benvrakas/1000W-LED-Controller/docs/Pics/IMG_6099.png

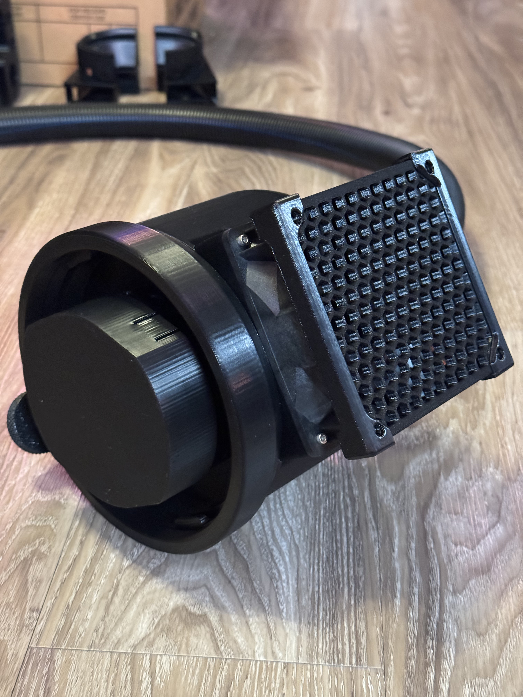
docs/Pics/IMG_6099.png
