benvrakas/1000W-LED-Controller/docs/Pin Uses.docx

Here are the connections for the Feather

Wrong Outdated Circuit Python Name! (Do Not Use) | Board Pin Number | Circuit Python Name | GPIO Name | Connected To
SPARE | 16 | D4 | PA14 | Aux lens cooling fan PWM
D1 | 19 | D5 | PA16 | Rad Fan PWM
D0 | 20 | D6 | PA18 | Pump PWM
D3 | 21 | D9 | PA19 | PSU fan PWM
D2 | 22 | D10 | PA20 | Rad Fan Tach
D5 | 23 | D11 | PA21 | Pump Tach
D4 | 24 | D12 | PA22 | PSU Fan Tach
D6 | 25 | D13 | PA23 | Aux lens cooling fan Tach
same | 14 | RX | PB17 | Encoder A
same | 15 | TX | PB16 | Encoder B
same | 17 | SDA | PA12 | Feather Wing OLED SDA
same | 18 | SCL | PA13 | Feather Wing OLED SLC
same | 5 | A0 | PA02 | 10K+10K voltage divider (thermistor connected to ground) for LED Temp
same | 6 | A1 | PA05 | 10K+10K voltage divider (thermistor connected to ground) for Water Temp
same | 7 | A2 | PA08 | Driving the switch LED
same | 8 | A3 | PA09 | Switch signal
same | 9 | A4 | PA04 | UHP 1500 Remote On OFF
same | 10 | A5 | PA06 | Unused

On the feather:

CanH is orange

CanL is red

Gnd is white
