benvrakas/1000W-LED-Controller/docs/Hardware/1000w LED.png

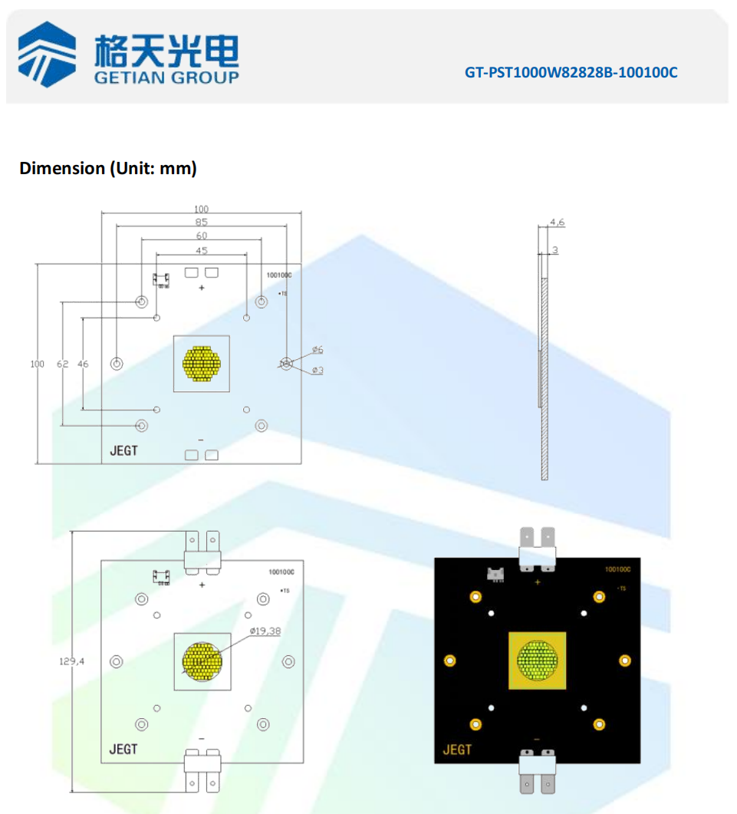
docs/Hardware/1000w LED.png
