benvrakas/1000W-LED-Controller/docs/Pics/IMG_5307.png

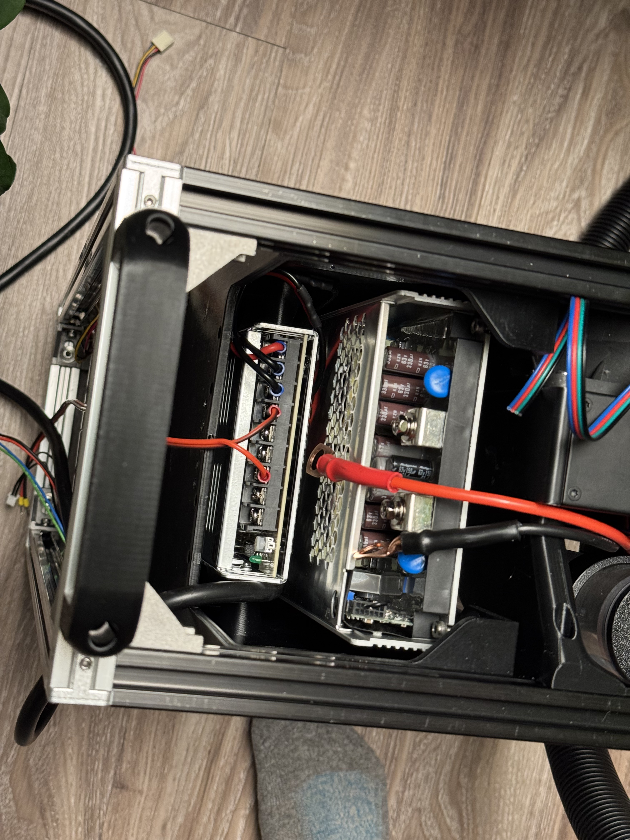
docs/Pics/IMG_5307.png
