benvrakas/1000W-LED-Controller/docs/Pics/Power Pack2.png

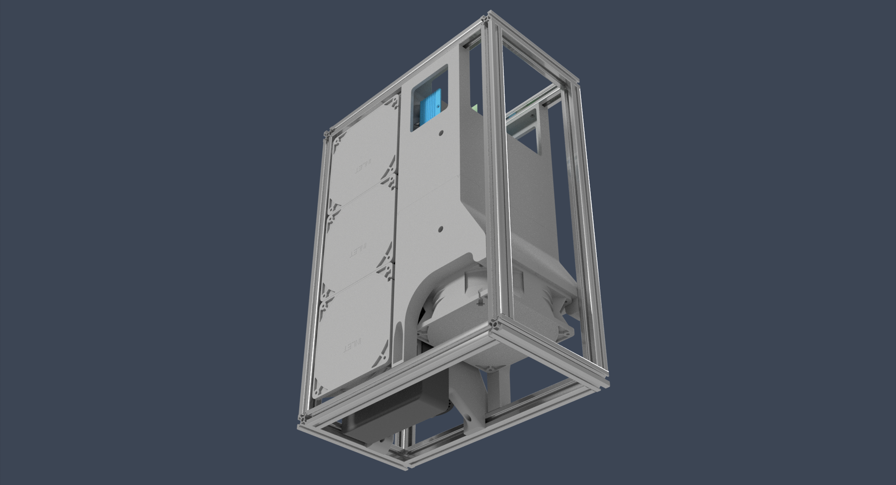
docs/Pics/Power Pack2.png
