benvrakas/1000W-LED-Controller/docs/Pics/Power Pack4.png

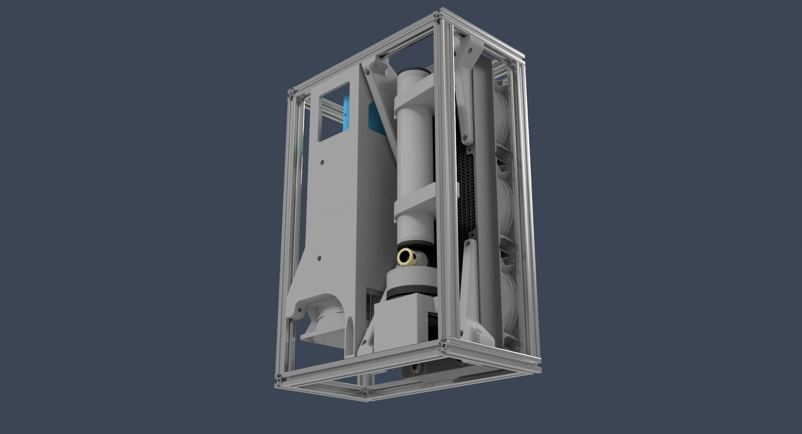
docs/Pics/Power Pack4.png
