benvrakas/1000W-LED-Controller/docs/Pics/Power Pack.png

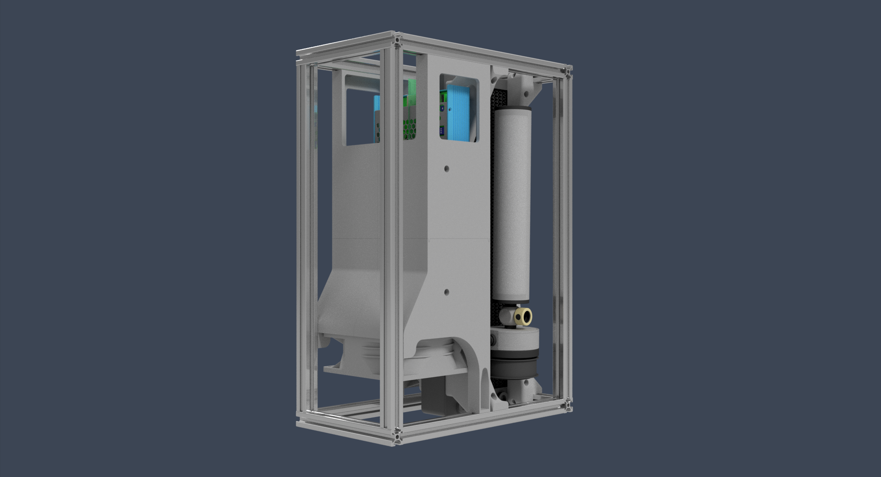
docs/Pics/Power Pack.png
