benvrakas/1000W-LED-Controller/docs/Pics/Screenshot_2026-01-21_124958.png

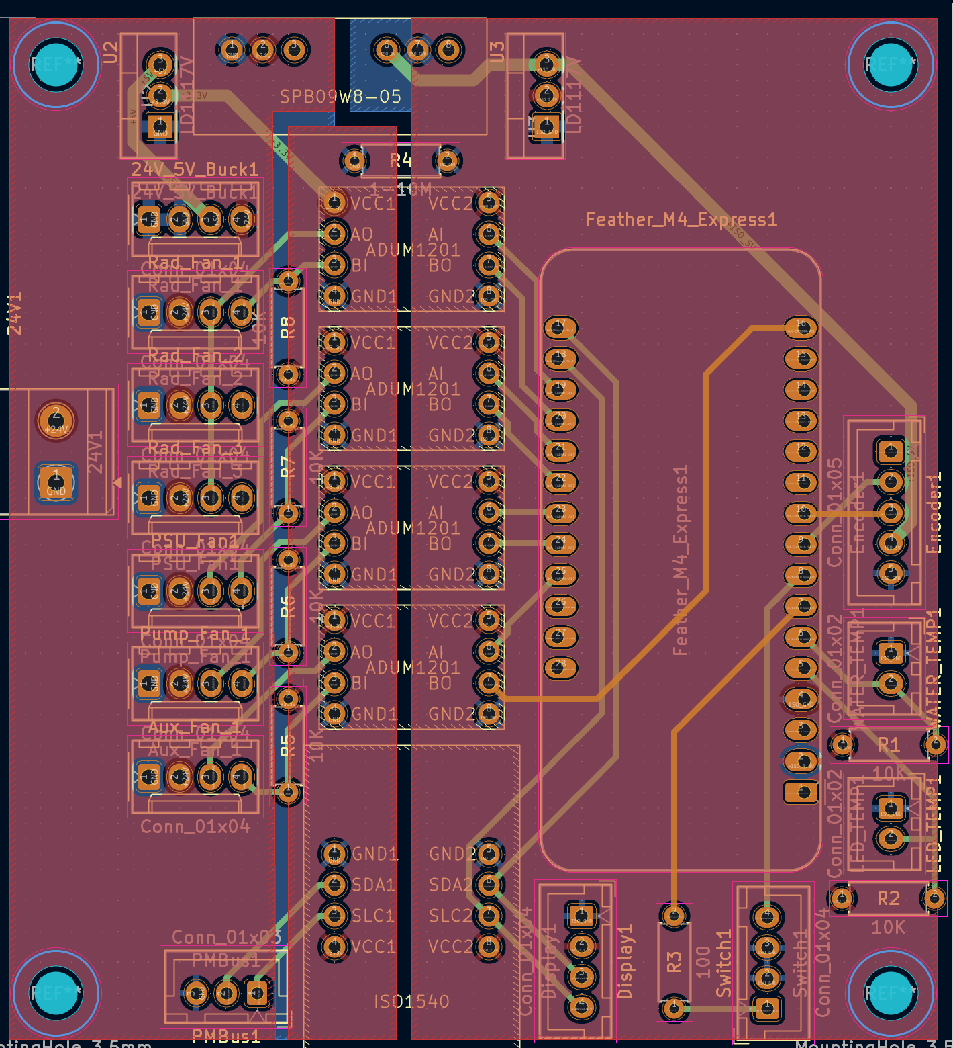
docs/Pics/Screenshot_2026-01-21_124958.png
