benvrakas/1000W-LED-Controller/docs/Pics/small/IMG_4872.jpg

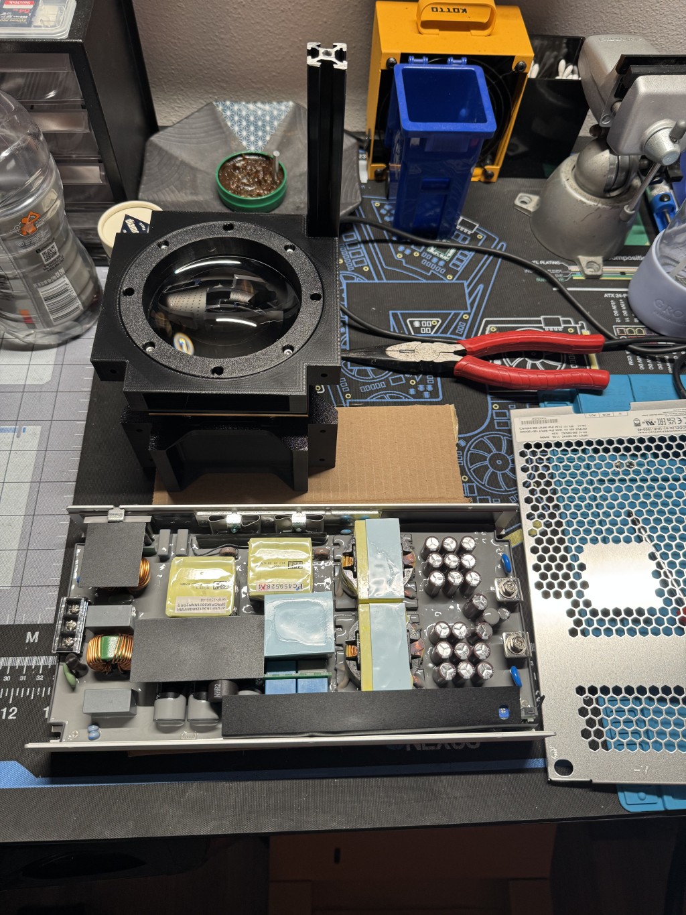
docs/Pics/small/IMG_4872.jpg
