benvrakas/1000W-LED-Controller/docs/Pics/small/IMG_5340.jpg

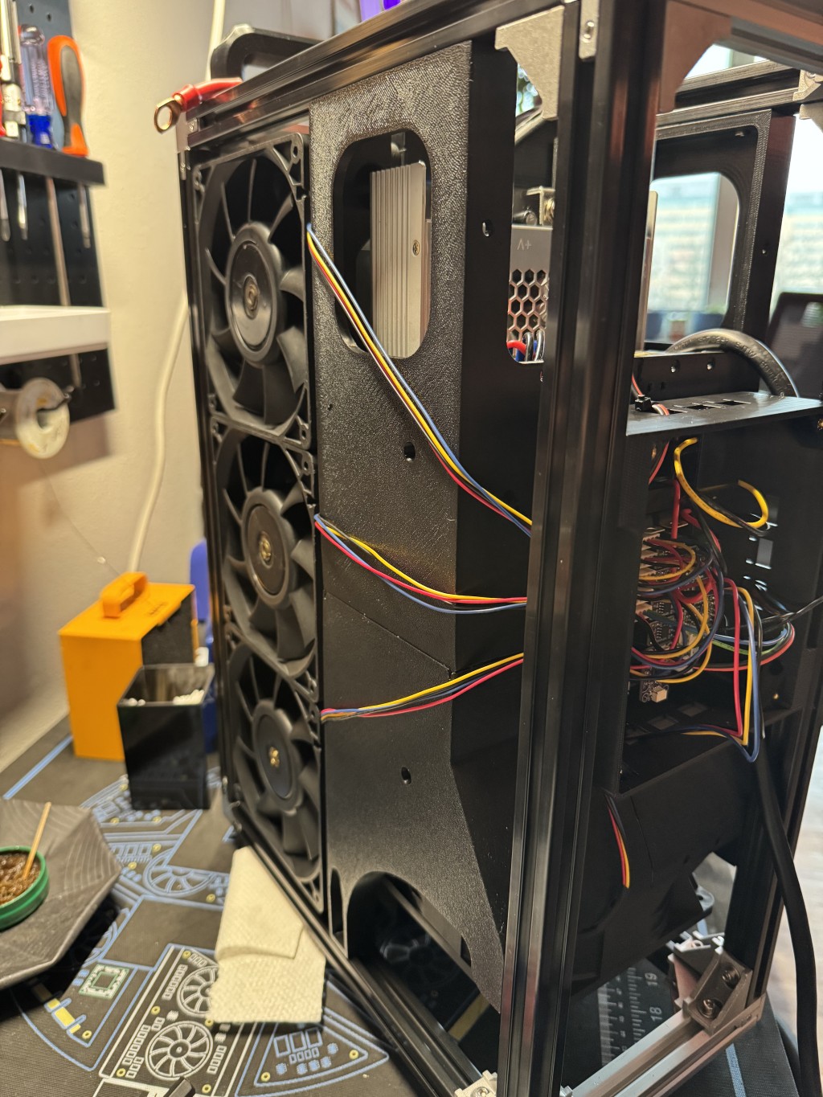
docs/Pics/small/IMG_5340.jpg
