benvrakas/1000W-LED-Controller/docs/Pics/small/IMG_5401.jpg

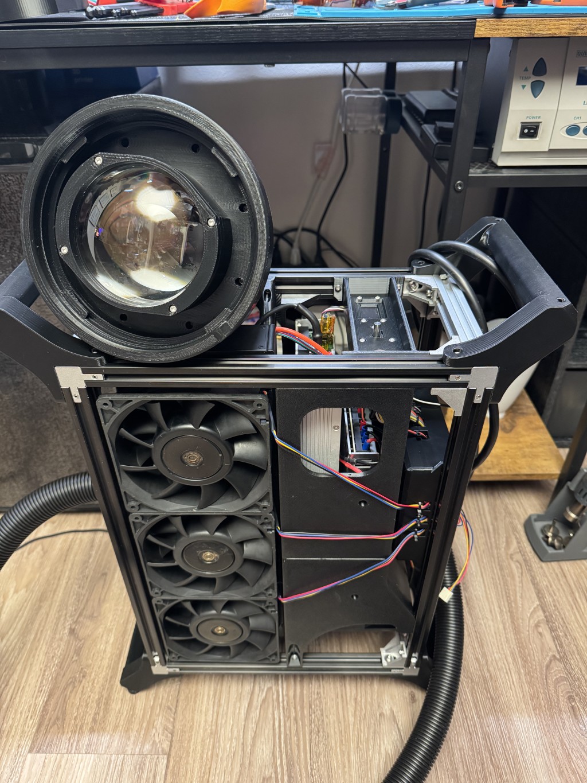
docs/Pics/small/IMG_5401.jpg
