benvrakas/1000W-LED-Controller/docs/Pics/small/IMG_6094.jpg

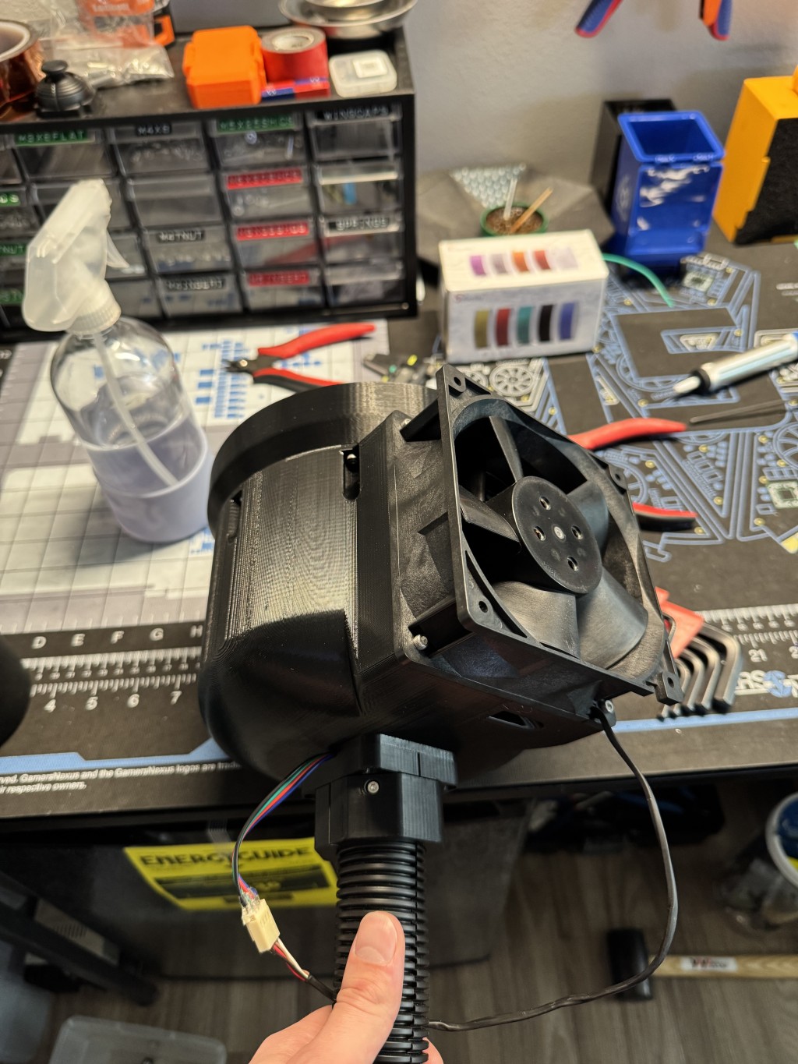
docs/Pics/small/IMG_6094.jpg
