benvrakas/1000W-LED-Controller/docs/Physical_Build_Features.md

# 1000W LED Controller: Physical Build Features

This document highlights the key physical and hardware features of the 1000W LED Controller project, based on an analysis of the assembled system. The build showcases a highly integrated blend of off-the-shelf industrial components, custom 3D-printed parts, and robust power delivery.

## 1. Chassis and Structural Framework
* **Aluminum Extrusion:** The core frame is constructed from 20mm x 20mm T-slot aluminum extrusion (2020 profile). This provides a rigid, modular backbone for securely mounting the heavy power supply, optics, and cooling components.
* **Power Pack Frame:** The power pack enclosure frame measures 480mm x 340mm x 180mm.
* **Custom 3D-Printed Brackets:** The extrusion framework is held together and augmented by custom 3D-printed corner brackets, handles, and mounting plates, ensuring precise alignment of the internal modules.
* **Integrated Handle:** A sturdy, thick 3D-printed top handle is built into the frame, allowing for safe transport of the heavy unit.

## 2. Light Engine and Optics
* **1000W COB LED:** The centerpiece of the build is a massive 1000W Chip-on-Board (COB) LED array.
* **Custom Optics Housing:** A meticulously designed, large 3D-printed housing holds the optical assembly.
* **Dual-Lens Collimation:** The optics feature a dual-lens setup:
  * An inner glass dome lens situated directly over the LED die.
  * A massive outer collimating lens designed to capture and focus the immense light output.
* **Baffling:** The interior of the optics housing includes 3D-printed structures to hold the lens elements securely and likely prevent light bleed.

## 3. Thermal Management (Cooling System)
Dissipating the heat from a 1000W LED requires an extreme cooling solution.
* **Direct-Die Liquid Cooling:** A liquid cooling block is mounted directly underneath the LED die. High-temperature rated corrugated tubing routes the coolant to and from the block.
* **High-Static Pressure Fans:** The side panel houses a bank of three large, high-RPM server-grade fans on the radiator (Delta FFB1424VHG-EP, 140mm).
* **Targeted Air Ducts:** Massive custom 3D-printed shrouds cover the internal electronics and heatsinks. These ducts ensure that the forced air from the server fans is channeled efficiently over critical heat-generating components (like internal finned heatsinks) rather than just blowing aimlessly through the chassis.
* **Honeycomb Exhaust:** A separate 3D-printed honeycomb grill with an attached fan provides additional exhaust or targeted component cooling.

## 4. Power Delivery
* **Primary Power Supply:** The system utilizes a massive Mean Well UHP-1500 fanless industrial power supply to provide the primary current for the 1000W LED.
* **Heavy-Duty Wiring:** The power connections from the UHP-1500 feature thick-gauge wiring with properly crimped ring terminals, bolted directly to the PSU's output lugs to handle the extreme current safely.
* **Secondary PSU:** A smaller secondary power supply is mounted alongside the main unit, likely providing logic-level voltages (5V/12V) for the microcontroller, fans, and sensors.

## 5. Electronics and Control
* **Microcontroller Bay:** The electronics are tucked into a dedicated bay. The wiring harness connects to what appears to be an Adafruit Feather M4 Express (with CAN bus capabilities).
* **Complex I/O Management:** The wiring bundle is substantial, reflecting the system's need to manage numerous inputs and outputs:
  * PWM control lines for the high-power fans.
  * Tachometer feedback wires for monitoring fan speeds.
  * Thermistor wiring for multi-point temperature monitoring.
  * CAN bus communication lines.
* **Cable Management:** Wiring is routed cleanly alongside the 3D-printed shrouds, utilizing zip ties and built-in channels to keep the interior organized and prevent airflow obstruction.
