benvrakas/1000W-LED-Controller/docs/Kicad/Temp Snapshot/1000W Controller/1000W Controller.kicad_pcb

## KiCad design docs/Kicad/Temp Snapshot/1000W Controller/1000W Controller.kicad_pcb (2026-09-02)

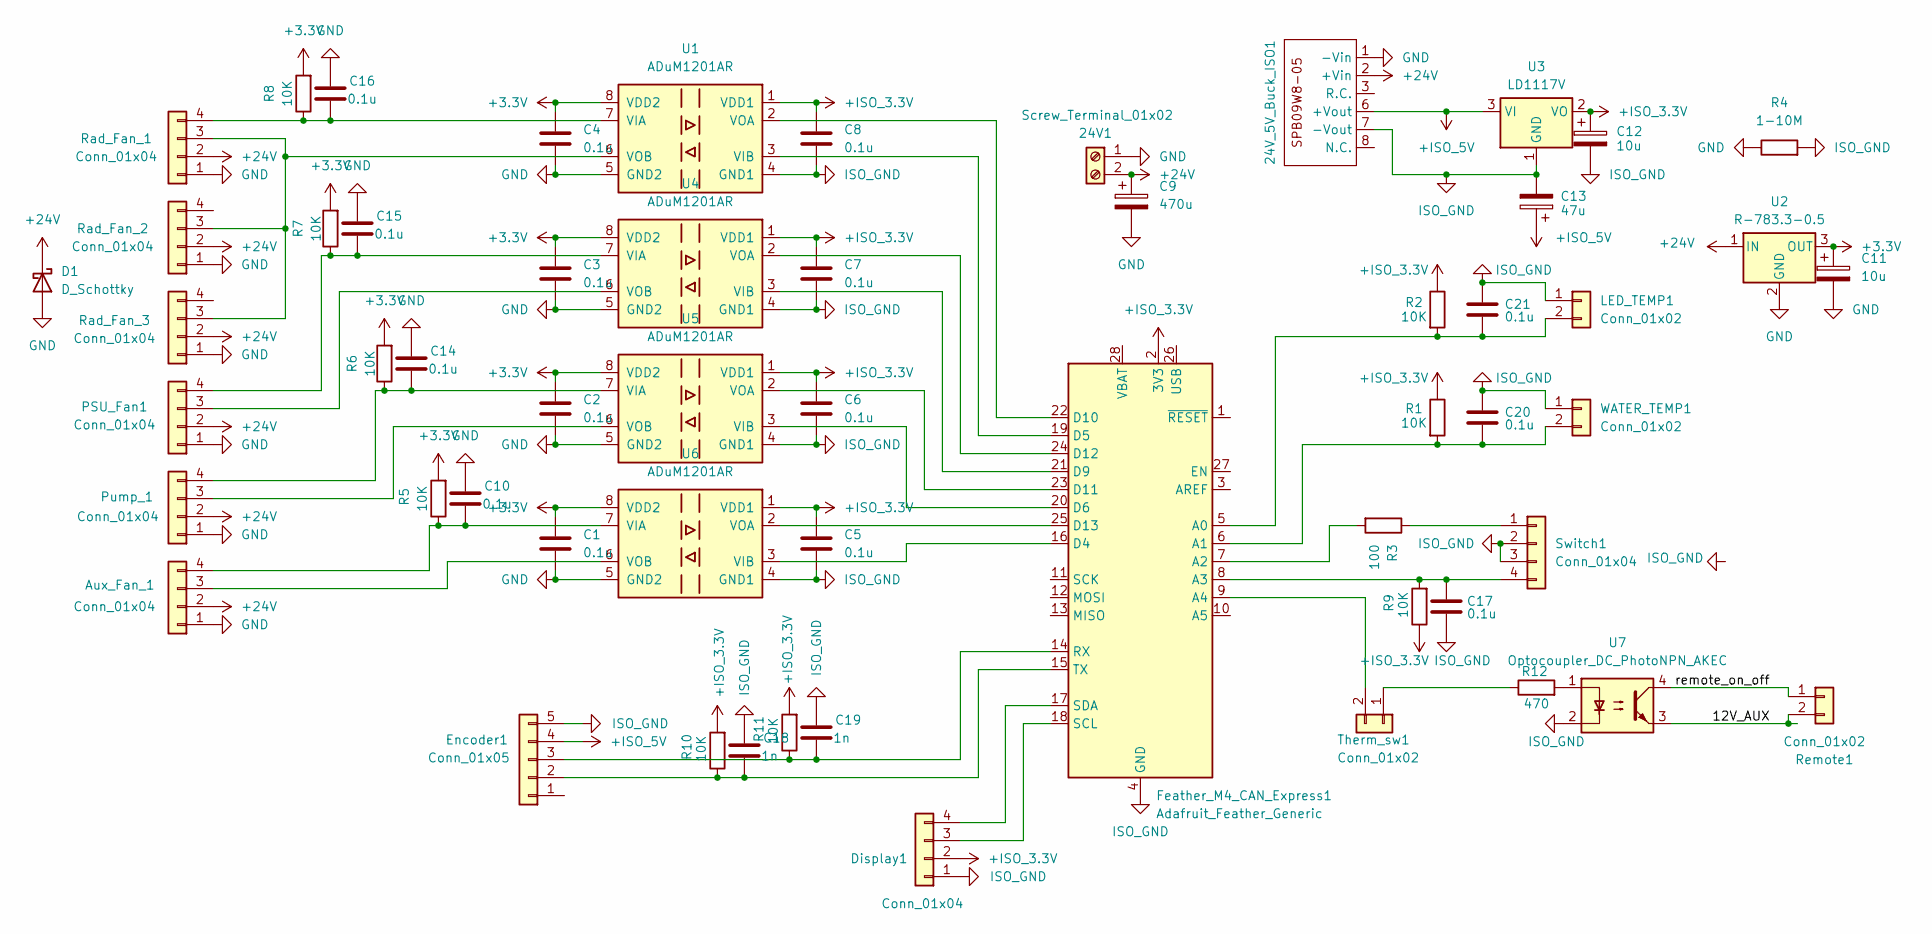
[picture p15: schematic 1000W Controller.kicad_sch]

Parts:
24V1: Screw_Terminal_01x02; TerminalBlock_Phoenix_MKDS-1,5-2-5.08_1x02_P5.08mm_Horizont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
24V_5V_Buck_ISO1: SPB09W8-05
Aux_Fan_1: Conn_01x04; Molex_KK-254_AE-6410-04A_1x04_P2.54mm_Vertical
C1, C2, C3, C4, C5, C6, C7, C8, C10, C14, C15, C16, C17, C20, C21: 0.1u; C_0805_2012Metric
C9: 470u; CP_Radial_D10.0mm_P5.00mm
C11, C12: 10u; C_0805_2012Metric
C13: 47u; C_1210_3225Metric
C18, C19: 1n; C_0805_2012Metric
D1: D_Schottky; D_DO-201AD_P15.24mm_Horizontal
Display1: Conn_01x04; JST_XH_B4B-XH-A_1x04_P2.50mm_Vertical
Encoder1: Conn_01x05; JST_XH_B5B-XH-A_1x05_P2.50mm_Vertical
Feather_M4_CAN_Express1: Adafruit_Feather_Generic; Adafruit_Feather
LED_TEMP1: Conn_01x02; JST_XH_B2B-XH-A_1x02_P2.50mm_Vertical
PSU_Fan1: Conn_01x04; Molex_KK-254_AE-6410-04A_1x04_P2.54mm_Vertical
Pump_1: Conn_01x04; Molex_KK-254_AE-6410-04A_1x04_P2.54mm_Vertical
R1, R2, R5, R6, R7, R8, R9, R10, R11: 10K; R_0805_2012Metric
R3: 100; R_0805_2012Metric
R4: 1-10M; R_0805_2012Metric
R12: 470; R_0805_2012Metric
Rad_Fan_1, Rad_Fan_2, Rad_Fan_3: Conn_01x04; Molex_KK-254_AE-6410-04A_1x04_P2.54mm_Vertical
Remote1: Conn_01x02; JST_XH_B2B-XH-A_1x02_P2.50mm_Vertical
Switch1: Conn_01x04; JST_XH_B4B-XH-A_1x04_P2.50mm_Vertical
Therm_sw1: Conn_01x02; JST_XH_B2B-XH-A_1x02_P2.50mm_Vertical
U1, U4, U5, U6: ADuM1201AR; SOIC-8_3.9x4.9mm_P1.27mm
U2: R-783.3-0.5; Converter_DCDC_RECOM_R-78E-0.5_THT
U3: LD1117V; TO-220-3_Vertical
U7: Optocoupler_DC_PhotoNPN_AKEC; DIP-4_W7.62mm
WATER_TEMP1: Conn_01x02; JST_XH_B2B-XH-A_1x02_P2.50mm_Vertical

Connections:
+3.3V: C1.1, C2.1, C3.1, C4.1, C11.1, R5.2, R6.2, R7.2, R8.2, U1.8 (VDD2), U2.3 (OUT), U4.8 (VDD2), U5.8 (VDD2), U6.8 (VDD2)
+24V: 24V1.2, 24V_5V_Buck_ISO1.2 (+Vin), Aux_Fan_1.2, C9.1, D1.1 (K), PSU_Fan1.2, Pump_1.2, Rad_Fan_1.2, Rad_Fan_2.2, Rad_Fan_3.2, U2.1 (IN)
+ISO_3.3V: C5.1, C6.1, C7.1, C8.1, C12.1, Display1.2, Feather_M4_CAN_Express1.2 (3V3), R1.1, R2.1, R9.1, R10.2, R11.2, U1.1 (VDD1), U3.2 (VO), U4.1 (VDD1), U5.1 (VDD1), U6.1 (VDD1)
+ISO_5V: 24V_5V_Buck_ISO1.6 (+Vout), C13.1, Encoder1.4, U3.3 (VI)
/12V_AUX: Remote1.2, U7.3
/remote_on_off: Remote1.1, U7.4
GND: 24V1.1, 24V_5V_Buck_ISO1.1 (-Vin), Aux_Fan_1.1, C1.2, C2.2, C3.2, C4.2, C9.2, C10.1, C11.2, C14.1, C15.1, C16.1, D1.2 (A), PSU_Fan1.1, Pump_1.1, R4.1, Rad_Fan_1.1, Rad_Fan_2.1, Rad_Fan_3.1, U1.5 (GND2), U2.2 (GND), U4.5 (GND2), U5.5 (GND2), U6.5 (GND2)
ISO_GND: 24V_5V_Buck_ISO1.7 (-Vout), C5.2, C6.2, C7.2, C8.2, C12.2, C13.2, C17.2, C18.1, C19.1, C20.1, C21.1, Display1.1, Encoder1.5, Feather_M4_CAN_Express1.4 (GND), LED_TEMP1.1, R4.2, Switch1.2, Switch1.3, U1.4 (GND1), U3.1 (GND), U4.4 (GND1), U5.4 (GND1), U6.4 (GND1), U7.2, WATER_TEMP1.1
unnamed: Aux_Fan_1.3, U6.6 (VOB)
unnamed: Aux_Fan_1.4, C10.2, R5.1, U6.7 (VIA)
unnamed: Display1.3, Feather_M4_CAN_Express1.18 (SCL)
unnamed: Display1.4, Feather_M4_CAN_Express1.17 (SDA)
unnamed: C18.2, Encoder1.2, Feather_M4_CAN_Express1.15 (TX), R10.1
unnamed: C19.2, Encoder1.3, Feather_M4_CAN_Express1.14 (RX), R11.1
unnamed: C21.2, Feather_M4_CAN_Express1.5 (A0), LED_TEMP1.2, R2.2
unnamed: C20.2, Feather_M4_CAN_Express1.6 (A1), R1.2, WATER_TEMP1.2
unnamed: Feather_M4_CAN_Express1.7 (A2), R3.2
unnamed: C17.1, Feather_M4_CAN_Express1.8 (A3), R9.2, Switch1.4
unnamed: Feather_M4_CAN_Express1.9 (A4), Therm_sw1.2
unnamed: Feather_M4_CAN_Express1.16 (D4), U6.3 (VIB)
unnamed: Feather_M4_CAN_Express1.19 (D5), U1.3 (VIB)
unnamed: Feather_M4_CAN_Express1.20 (D6), U5.3 (VIB)
unnamed: Feather_M4_CAN_Express1.21 (D9), U4.3 (VIB)
unnamed: Feather_M4_CAN_Express1.22 (D10), U1.2 (VOA)
unnamed: Feather_M4_CAN_Express1.23 (D11), U5.2 (VOA)
unnamed: Feather_M4_CAN_Express1.24 (D12), U4.2 (VOA)
unnamed: Feather_M4_CAN_Express1.25 (D13), U6.2 (VOA)
unnamed: PSU_Fan1.3, U4.6 (VOB)
unnamed: C15.2, PSU_Fan1.4, R7.1, U4.7 (VIA)
unnamed: Pump_1.3, U5.6 (VOB)
unnamed: C14.2, Pump_1.4, R6.1, U5.7 (VIA)
unnamed: R12.2, U7.1
unnamed: Rad_Fan_1.3, Rad_Fan_2.3, Rad_Fan_3.3, U1.6 (VOB)
unnamed: C16.2, R8.1, Rad_Fan_1.4, U1.7 (VIA)
unnamed: R3.1, Switch1.1
unnamed: R12.1, Therm_sw1.1

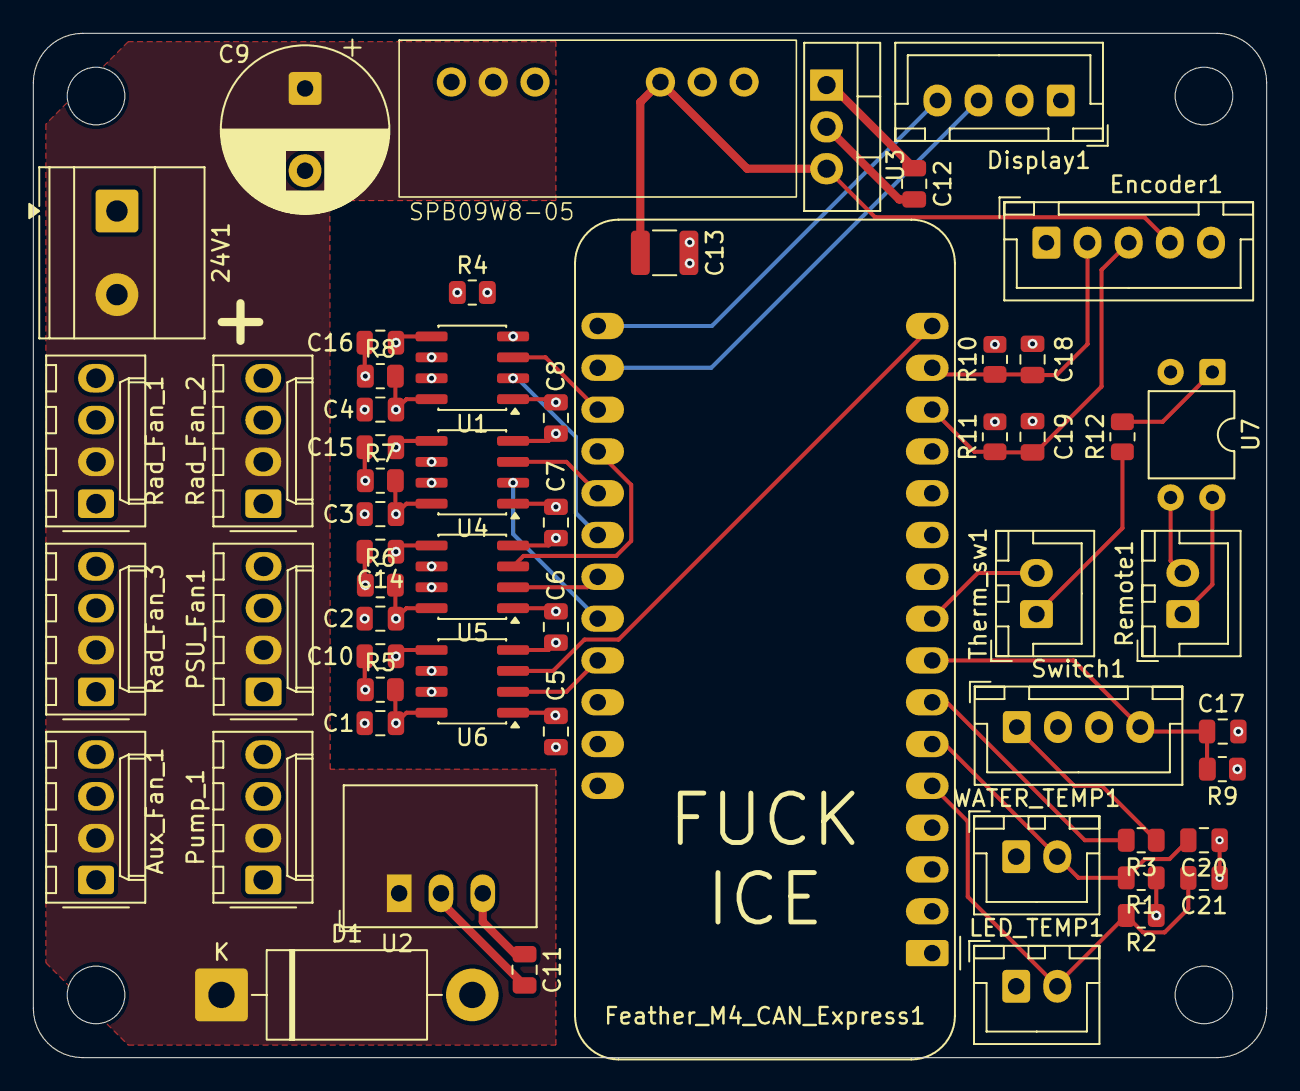
[picture p16: board 1000W Controller.kicad_pcb from above]

Board: 4 copper layers, 74.9 x 62.2 mm, 57 parts (0 on the bottom side), 36 nets.
