benvrakas/1000W-LED-Controller/ProjectorMaster/src/StateInit.cpp

#include "SystemController.h"
#include "StateInit.h"
#include "BoardPins.h"
#include "OLED.h"
#include "PMBus.h"

//Handler Function Implementation
void handleInitState(SystemController &sys, unsigned long now) {
    //Button interupt check

    //Define variables
    static SystemStartup startup;
    auto &data = sys.stateData.init;
    

    //Switch statement where we go through all init steps and verify they are safe
    switch (data.bootStep) {
        case 1: //Board pins init
            startup.boardPinsInit();
            startup.boardPinsVerify(data.bootStep);

            //Check that our hardware system is ready, if so move to next case
            if(startup.getStepStatus(data.bootStep)) {
                data.lastStepTime = now;
                data.bootStep = 2; 
            }
            break;
        
        case 2: //Pump init
            startup.pumpInit();

            if(startup.getStepStatus(data.bootStep)) {
                data.lastStepTime = now;
                data.bootStep = 3; 
            }
            break;

        case 3: //Fans init
            startup.fansInit();

            if(startup.getStepStatus(data.bootStep)) {
                data.lastStepTime = now;
                data.bootStep = 4; 
            }
            break;

        case 4: //PSU init
            startup.psuInit();

            if(startup.getStepStatus(data.bootStep)) {
                data.lastStepTime = now;
                data.bootStep = 5; 
            }
            break;

        case 5: //Display init
            startup.displayInit();

            if(startup.getStepStatus(data.bootStep)) {
                data.lastStepTime = now;
                data.bootStep = 6; 
            }
            break;

        case 6: //Final check
            
            if (data.systemReady) {
                sys.transitionTo(SystemState::ONOFF);
            } 
            break;

        default: //Illegal boot step or error got flagged, assume error
            sys.transitionTo(SystemState::ERROR_KILL);
            return;
    }

    //Local Logic Watchdog
    if (now - data.lastStepTime > 500) {
        sys.transitionTo(SystemState::ERROR_KILL);
        return;
    }
}

//Start up class definition 
SystemStartup::SystemStartup() 
    : _boardPinsReady(false), _pumpReady(false), _fansReady(false),
      _psuReady(false), _displayReady(false), _encoderReady(false),
      _thermistorsReady(false) 
{}

//Function definitions 
//Getters and  Setters
bool SystemStartup::getStepStatus(uint8_t bootStep) const{
    switch (bootStep) {
        case 1:  return _boardPinsReady;
        case 2:  return _pumpReady;
        case 3:  return _fansReady;
        case 4:  return _psuReady;
        case 5:  return _displayReady;
        default: return false; //log it, Watchdog for logic will kill the proccess
    }
}

void SystemStartup::setStepStatus(uint8_t bootStep, bool status) {
    switch (bootStep) {
        case 1: _boardPinsReady = status;    break;
        case 2: _pumpReady = status;         break;
        case 3: _fansReady = status;         break;
        case 4: _psuReady = status;          break;
        case 5: _displayReady = status;      break;
        default: break; //log it, Watchdog for logic will kill the proccess
    }
}

//Initialization Functions
//Board pins
void SystemStartup::boardPinsInit() {
    // Encoder Sensor Setup
    pinMode(BoardPins::PIN_ENCODER_A, INPUT_PULLUP);
    pinMode(BoardPins::PIN_ENCODER_B, INPUT_PULLUP);

    // Power Button Setup
    pinMode(BoardPins::PIN_SW_BTN, INPUT_PULLUP);
    pinMode(BoardPins::PIN_SW_LED, OUTPUT);
    digitalWrite(BoardPins::PIN_SW_LED, LOW); // Start with LED off

    // Thermal Sensor Setup
    pinMode(BoardPins::PIN_THERM_LED, INPUT);
    pinMode(BoardPins::PIN_THERM_WATER, INPUT);

    // PWM Outputs - Force LOW immediately for safety
    pinMode(BoardPins::PIN_RAD_FANS_PWM, OUTPUT);
    digitalWrite(BoardPins::PIN_RAD_FANS_PWM, LOW);
    
    pinMode(BoardPins::PIN_PUMP_PWM, OUTPUT);
    digitalWrite(BoardPins::PIN_PUMP_PWM, LOW);
    
    pinMode(BoardPins::PIN_PSU_FAN_PWM, OUTPUT);
    digitalWrite(BoardPins::PIN_PSU_FAN_PWM, LOW);

    pinMode(BoardPins::PIN_AUX_FAN_PWM, OUTPUT);
    digitalWrite(BoardPins::PIN_AUX_FAN_PWM, LOW);

    // Tachometer Inputs
    pinMode(BoardPins::PIN_RAD_FAN_TACH, INPUT);
    pinMode(BoardPins::PIN_PUMP_TACH, INPUT);
    pinMode(BoardPins::PIN_PSU_FAN_TACH, INPUT);
    pinMode(BoardPins::PIN_AUX_FAN_TACH, INPUT);

    // Startup I2C Connection
    Wire.begin(BoardPins::PIN_I2C_SDA, BoardPins::PIN_I2C_SCL);
    Wire.setClock(PMBusConfig::BUS_SPEED);

    // Verify the safe connection settings
    
}

// Verify the safe connection settings
void SystemStartup::boardPinsVerify(uint8_t bootStep) {
    if (
        isPinSetAsInput(BoardPins::PIN_ENCODER_A) && 
        isPinSetAsInput(BoardPins::PIN_ENCODER_B) &&
        isPinSetAsInput(BoardPins::PIN_RAD_FAN_TACH) &&
        isPinSetAsInput(BoardPins::PIN_PUMP_TACH) &&
        isPinSetAsInput(BoardPins::PIN_PSU_FAN_TACH) &&
        isPinSetAsInput(BoardPins::PIN_AUX_FAN_TACH) &&
        
        // Check Input + Pullup state (High = not pressed)
        (isPinSetAsInput(BoardPins::PIN_SW_BTN) && digitalRead(BoardPins::PIN_SW_BTN) == HIGH) &&
        
        // Check Outputs + Safety Low state
        (isPinSetAsOutput(BoardPins::PIN_RAD_FANS_PWM) && digitalRead(BoardPins::PIN_RAD_FANS_PWM) == LOW) &&
        (isPinSetAsOutput(BoardPins::PIN_PUMP_PWM) && digitalRead(BoardPins::PIN_PUMP_PWM) == LOW) &&
        (isPinSetAsOutput(BoardPins::PIN_PSU_FAN_PWM) && digitalRead(BoardPins::PIN_PSU_FAN_PWM) == LOW) &&
        (isPinSetAsOutput(BoardPins::PIN_AUX_FAN_PWM) && digitalRead(BoardPins::PIN_AUX_FAN_PWM) == LOW) &&
        
        // Thermistor Sane Range Check
        (analogRead(BoardPins::PIN_THERM_WATER) > 10 && analogRead(BoardPins::PIN_THERM_WATER) < 1010) &&
        (analogRead(BoardPins::PIN_THERM_LED) > 10 && analogRead(BoardPins::PIN_THERM_LED) < 1010) &&

        // Check Encoder current readouts
        (digitalRead(BoardPins::PIN_ENCODER_A) == HIGH || digitalRead(BoardPins::PIN_ENCODER_B) == HIGH)
    )   {setStepStatus(bootStep, true);}
}

    //Helper functions for board pins initialization
    //Verifies pin register direction
    bool SystemStartup::isPinSetAsOutput(uint8_t pin) const {
        if (pin >= PINS_COUNT) return false; // Safety guard

        uint32_t pinMask = 1ul << g_APinDescription[pin].ulPin;
        uint32_t port = g_APinDescription[pin].ulPort;
        
        // Logic: Output if bit is NOT 0
        return (PORT->Group[port].DIR.reg & pinMask) != 0;
    }

    bool SystemStartup::isPinSetAsInput(uint8_t pin) const {
        if (pin >= PINS_COUNT) return false; // Safety guard

        uint32_t pinMask = 1ul << g_APinDescription[pin].ulPin;
        uint32_t port = g_APinDescription[pin].ulPort;
        
        // Logic: Input if bit IS 0
        return (PORT->Group[port].DIR.reg & pinMask) == 0;
    }

//Pump
    void SystemStartup::pumpInit() {

    }

//Fans
    void SystemStartup::fansInit() {
        
    }

//PSU
    void SystemStartup::psuInit() {
        
    }

//Display
    void SystemStartup::displayInit() {
        
    }
