benvrakas/1000W-LED-Controller/(commit log)

2026-01-01 Initial Commit: 1000W LED Projector Controller
2026-01-25 Device drivers update
2026-02-20 Mostly Power Button Code Changes
2026-03-22 Error LED
2026-09-02 Per-channel fault ignoring, cooling/PSU control overhaul, docs refresh
    Replaces the old global "unsafe mode" bypass with per-channel fault
    ignoring: a 3s hold in ERROR_KILL now permanently silences only the
    specific channel at fault (of 8: LED/water temp, pump, main/PSU/aux
    fan, PSU comms, encoder), not all fault checking. Fixes the long-
    standing 0-RPM tach bug (a redundant pinMode() call was clobbering the
    EIC pin-mux after interrupt attachment). Reworks CoolingService: main
    fan now runs the sole PI loop, targeting water temp; PSU/aux fans
    track LED duty with a fixed linear ratio; pump duty is now a flat
    constant with no PI loop. Adds a 110% LED current overclock
    (MAX_LED_CURRENT_A), peak-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
    [1000W Controller-B_Cu.gbr, 1000W Controller-B_Mask.gbr, 1000W Controller-B_Paste.gbr, 1000W Controller-B_Silkscreen.gbr, 1000W Controller-Edge_Cuts.gbr, 1000W Controller-F_Cu.gbr, 1000W Controller-F_Mask.gbr, 1000W Controller-F_Paste.gbr]
