benvrakas/1000W-LED-Controller/docs/Pics/IMG_6093.png

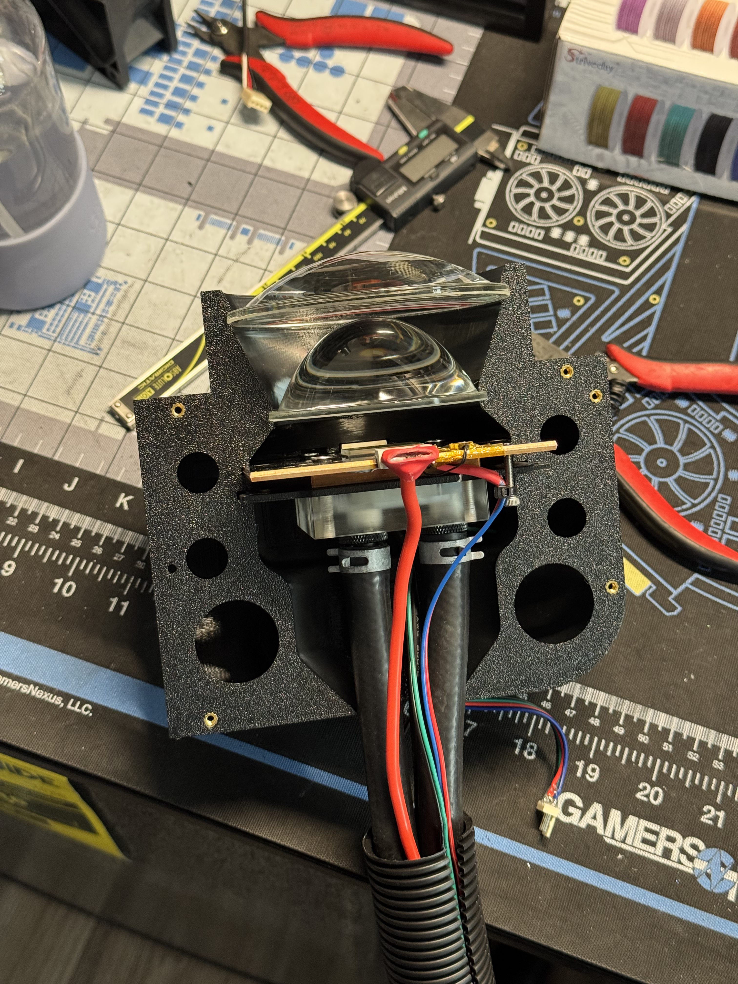
docs/Pics/IMG_6093.png
